10-min/stm32-drone-project/README.md

# STM32 Drone Project

## Overview
- 이 프로젝트의 목표는 STM32 마이크로컨트롤러를 사용하여 맞춤형 자작 드론을 설계하고 제작하는 것입니다. 기본 비행 제어, 안정화, 무선 통신 구현에 중점을 두었습니다.

## Objective
- STM32 프로그래밍을 학습하고 드론 하드웨어 제어에 적용.
- 기본 비행 안정화 알고리즘 개발.
- 원격 제어를 위한 무선 통신 모듈 통합.
- 드론 조립 및 테스트를 통해 실습 경험 획득.

## Hardware
- MCU: STM32F103RBT6 / 72 MHz, up to 1 Mbyte of Flash with motor control, USB and CAN
- Frame: ABS 플라스틱 재질, F330 4-Axis Frame
- Motor: BLDC, A2212 1400KV
- Propeller: 8045 plastic propeller for Quardcopter
- ESC: Hobbywing skywalker 20A
- Battery: 3S, 1800mAh Lipo battery
- Sensor
  - IMU: MPU6050
  - Wireless Communication: HC-06 (Bluetooth)

## Tool and Framework

| | |
| --- | --- |
| IDE | STM32CubeIDE |
| Firmware Development | STM32 HAL Library |
| Programming Language | C |
| Communication Protocols | I2C(IMU), UART(HC-06, Debugging) | 
| Drone Control Algorithms | PID Control |

## Features
- IMU 센서와 PID 제어의 융합으로 정밀한 비행 안정화 구현
- 칼만 필터 적용으로 센서 노이즈를 완벽 제거하여 제어 정밀도 극대화
- HC-06 블루투스 모듈 기반 스마트폰 원격 조종 기능 제공
- 일정 시간 신호 부재 시 모터 자동 정지로 안전 비상 대응 시스템 탑재

## Implements

### Apperance
- 정면



- 측면



- 후면



- 상면



### Hardware Setting ([Blog](https://blog.naver.com/xoals5315/223570628156))
- STM32 Board는 프레임 상단에 양면 테이프로 고정

- HC-06 및 전원 회로는 Mini Bread Board를 부착하여 연결
  
  
- ESC와 Motor는 납땜으로 직접 연결
  
  
  
- 배터리 전원부는 XT-60 connector로 부착
  
  
  
- MPU6050은 진동 감쇠를 위해 프레임 하단부에 고무 패드 부착후 댐퍼 추가하여 연결
  
  
  
- 프로펠러는 좌측정면, 우측후면은 CW, 우측정면, 좌측후면은 CCW 방향으로 설정

### Software Implements
- **Wireless Bluetooth Communication Android Application**
  - Home
  
    
    
  - Controller
  
    

  - Android Studio 사용
  - Controller는 Canvas를 사용해 구현하였으며, 2개의 조이스틱을 구현
  - 좌측은 Pitch, Roll, 우측은 Throttle, Yaw 제어
  
- **ESC Calibration**
  - STM32 PWM 제어 400Hz 세팅
  - 1-2ms 신호를 최소에서 최대값으로 감지
  - 드론에 사용된 ESC는 다음과 같은 Calibration 과정이 필요
    > 1. Throttle 최대인 상태 유지
    > 2. 전원을 키고 2초간 대기
    > 3. Beep-Beep tone이 방출됨
    > 4. 다시 Throttle을 최소로 내리면 Beep tone이 여러번 울림
    > 5. Beep tone이 길게 울리면 최소-최대 범위가 확인됨

- **MPU-6050**
  - Stm32 SPI 통신을 위해 Open Source Library 사용 [Git](https://github.com/mokhwasomssi/stm32_hal_mpu6050.git)
  - DLPF(Digital Low Pass Filter)를 사용하기 위해 set_DLPF 함수 추가

- **PID Control**
  - 안정화를 위해 P-PID Dual PID 제어를 사용
  - P는 Target angle과 current angle과의 diff
  - Dual P는 P * stabilize_kp와 각속도와의 차이
 
- **Filter**
  - 개발 초기 Low pass filter와 DLPF를 사용했으며, DLPF 정도를 높여서 안정성을 높였음
  - DLPF 사용 시 안정성은 높아졌지만, 반응 속도가 느려 다른 방안을 탐구함
  - 이후 Kalman filter를 적용하여 안정화를 한 층 더 높일 수 있었음
 
## Test
- 테스트1

Test1 (https://www.youtube.com/watch?v=l1rKK0Qbktg)

  - 높은 곳에서 컨트롤이 미숙해 낙하하여 Frame 다리가 손상

- 테스트2
  - Frame 손상 이후 랜딩 기어를 추가하여 다시 테스트 (Low pass filter + DLPF)

Test2 (https://www.youtube.com/watch?v=jNpG6de5bn8)

  - DLPF를 적용해도 조작 없이 센서값이 튀는 걸 볼 수 있음
  - 이후 MPU-6050을 하단부에 고정하고 Low pass filter에서 Kalman filter로 바꿔 적용함
  - DLPF를 한 단계 낮춰도 안정성이 강화되었으며, 그에 따라 반응 속도도 빨라질 수 있었음
