10-min/stm32-drone-project/drone/drone.ioc

Mcu.UserName=STM32F103RBTx
PA10.Signal=S_TIM1_CH3
PA11.Signal=S_TIM1_CH4
PA13.Signal=SYS_JTMS-SWDIO
PA14.Signal=SYS_JTCK-SWCLK
PA2.Signal=USART2_TX
PA3.Signal=USART2_RX
PA8.Signal=S_TIM1_CH1
PA9.Signal=S_TIM1_CH2
PB10.Signal=USART3_TX
PB11.Signal=USART3_RX
PB8.Signal=I2C1_SCL
PB9.Signal=I2C1_SDA
