10-min/stm32-drone-project/(notices)

Notices in the files:
drone/Core/Src/main.c:
Copyright (c) 2024 STMicroelectronics.
All rights reserved.
This software is licensed under terms that can be found in the LICENSE file
